esden/pretty-kicad-libs/README.md

This project has moved to [codeberg](https://codeberg.org/esden/pretty-kicad-libs).
