esden/pretty-kicad-libs/3d_models/M2_Standoff/M2_Standoff.FCStd

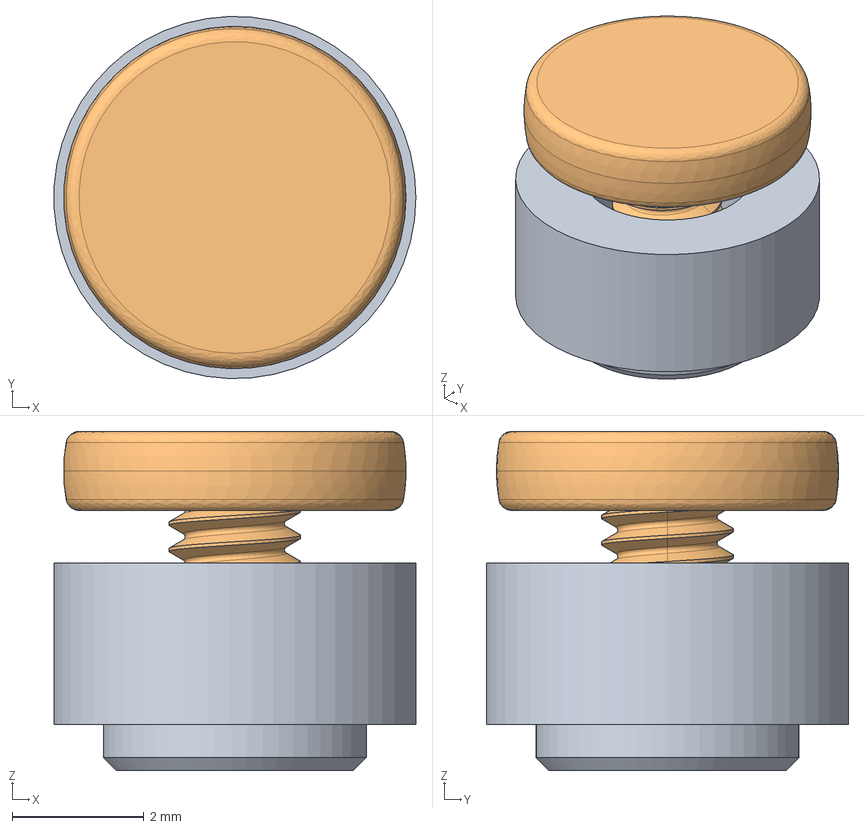
[picture p1: CAD file, 2021-06-23, last stored version]
3d_models/M2_Standoff/M2_Standoff.FCStd
5.49 x 5.50 x 5.15 mm
