esden/pretty-kicad-libs/3d_models/NGFF_Module/NGFF_Module.FCStd

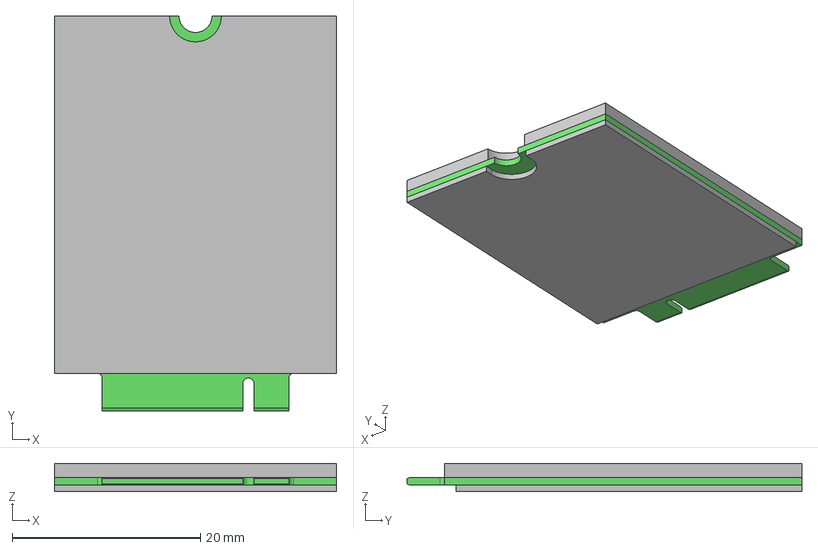
[picture p2: CAD file, 2021-06-23, last stored version]
3d_models/NGFF_Module/NGFF_Module.FCStd
30.0 x 42.0 x 3.00 mm
