esden/pretty-kicad-libs/3d_models/PogoPin_D0.68mm_L16.5mm/PogoPin_D0.68mm_L16.5mm.FCStd

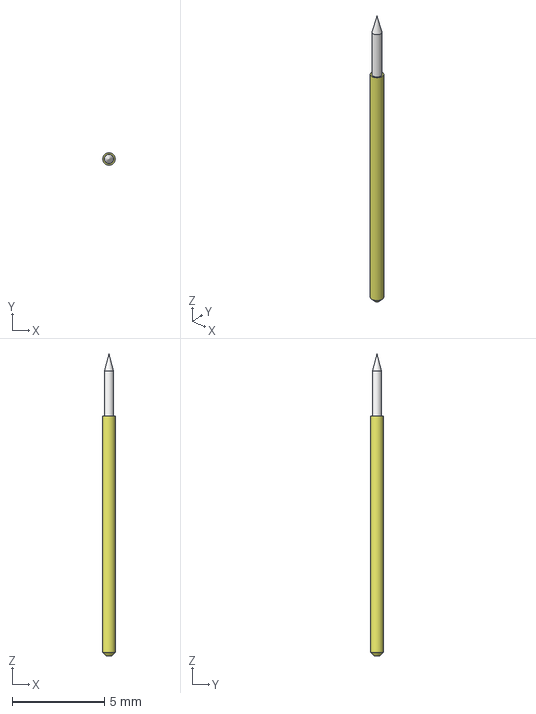
[picture p3: CAD file, 2021-06-23, last stored version]
3d_models/PogoPin_D0.68mm_L16.5mm/PogoPin_D0.68mm_L16.5mm.FCStd
0.679 x 0.68 x 16.4 mm
Sleeve001
Pin
