esden/pretty-kicad-libs/3d_models/M2_Screw/M2_Screw.FCStd

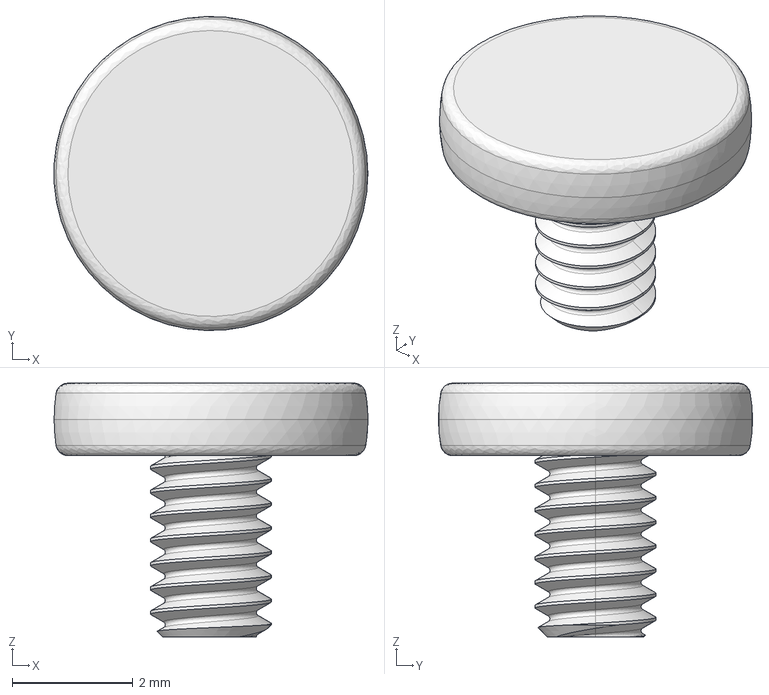
[picture p4: CAD file, 2021-06-23, last stored version]
3d_models/M2_Screw/M2_Screw.FCStd
5.20 x 5.20 x 4.20 mm
