esden/pretty-kicad-libs/3d_models/Molex_SL/705430041.stp

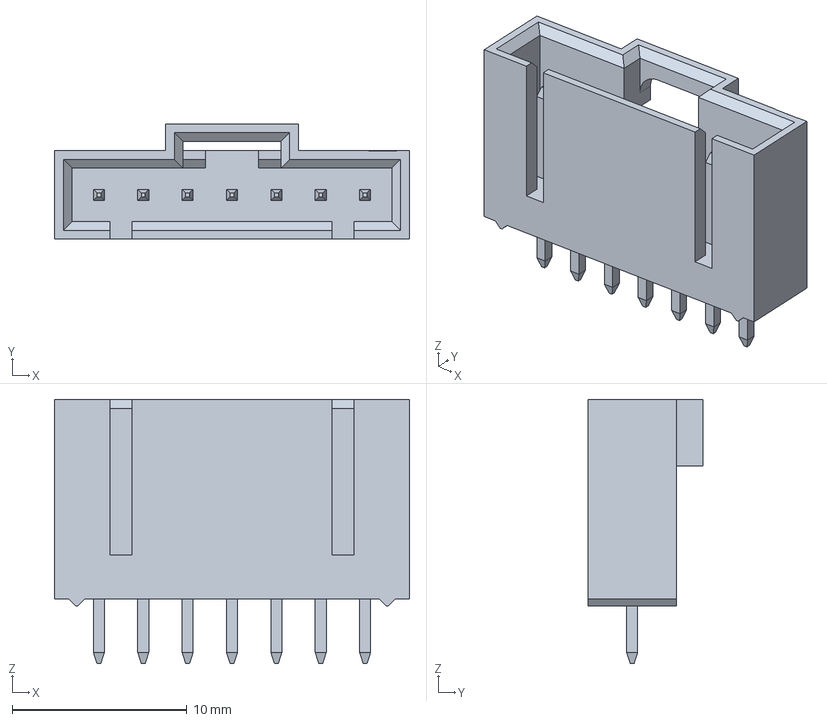
[picture p5: CAD file, 2024-10-26, last stored version]
3d_models/Molex_SL/705430041.stp
20.3 x 6.60 x 15.1 mm
