esden/pretty-kicad-libs/3d_models/Molex_SL/705430045.stp

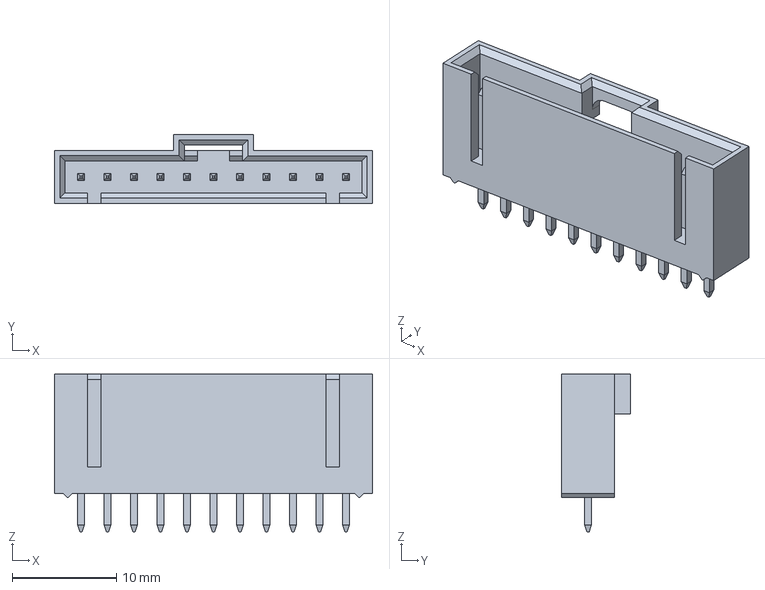
[picture p6: CAD file, 2024-10-26, last stored version]
3d_models/Molex_SL/705430045.stp
30.5 x 6.60 x 15.1 mm
