esden/pretty-kicad-libs/3d_models/Molex_SL/705430056.stp

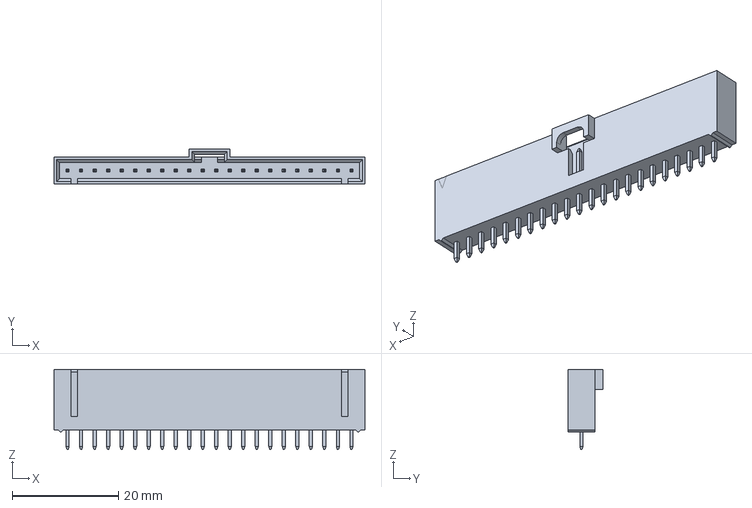
[picture p7: CAD file, 2024-10-26, last stored version]
3d_models/Molex_SL/705430056.stp
58.4 x 6.60 x 15.1 mm
