esden/pretty-kicad-libs/3d_models/Molex_SL/705430044.stp

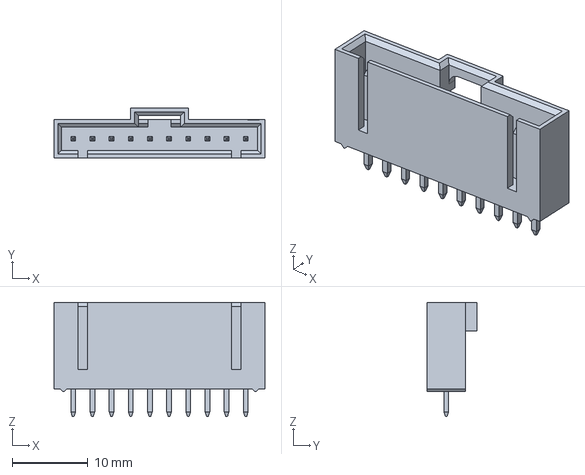
[picture p8: CAD file, 2024-10-26, last stored version]
3d_models/Molex_SL/705430044.stp
27.9 x 6.60 x 15.1 mm
