esden/pretty-kicad-libs/3d_models/Molex_SL/705430053.stp

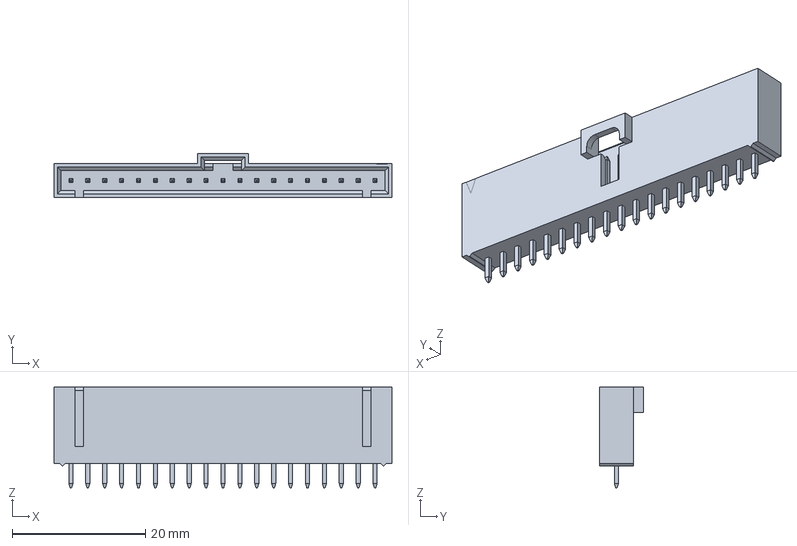
[picture p9: CAD file, 2024-10-26, last stored version]
3d_models/Molex_SL/705430053.stp
50.8 x 6.60 x 15.1 mm
