esden/pretty-kicad-libs/3d_models/Molex_SL/705430038.stp

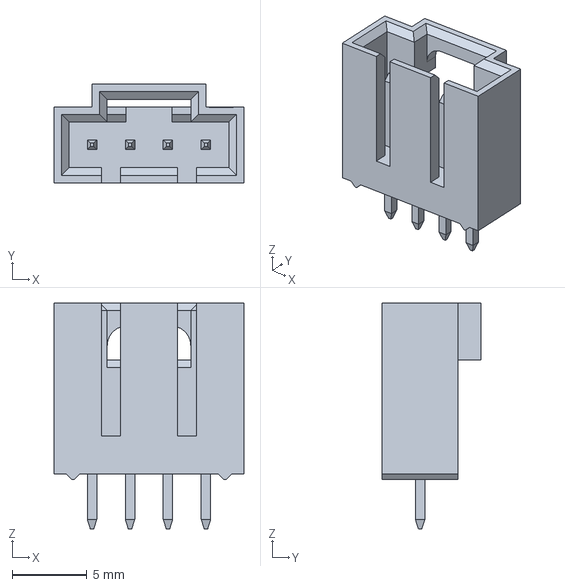
[picture p10: CAD file, 2024-10-26, last stored version]
3d_models/Molex_SL/705430038.stp
12.7 x 6.60 x 15.1 mm
