esden/pretty-kicad-libs/3d_models/Molex_SL/705430048.stp

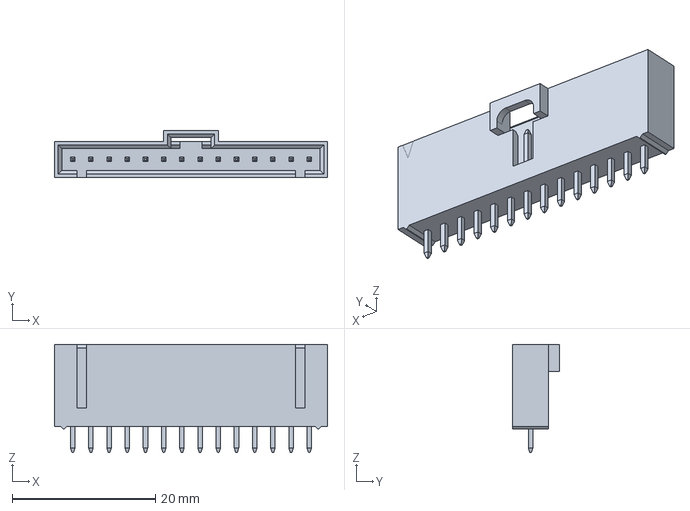
[picture p11: CAD file, 2024-10-26, last stored version]
3d_models/Molex_SL/705430048.stp
38.1 x 6.60 x 15.1 mm
