esden/pretty-kicad-libs/3d_models/Molex_SL/705430052.stp

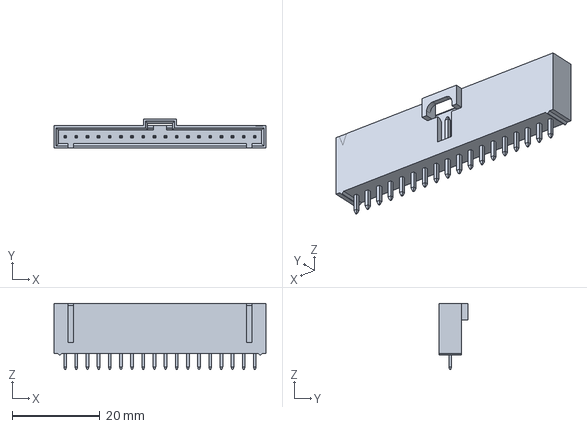
[picture p12: CAD file, 2024-10-26, last stored version]
3d_models/Molex_SL/705430052.stp
48.3 x 6.60 x 15.1 mm
