esden/pretty-kicad-libs/3d_models/Molex_SL/705430059.stp

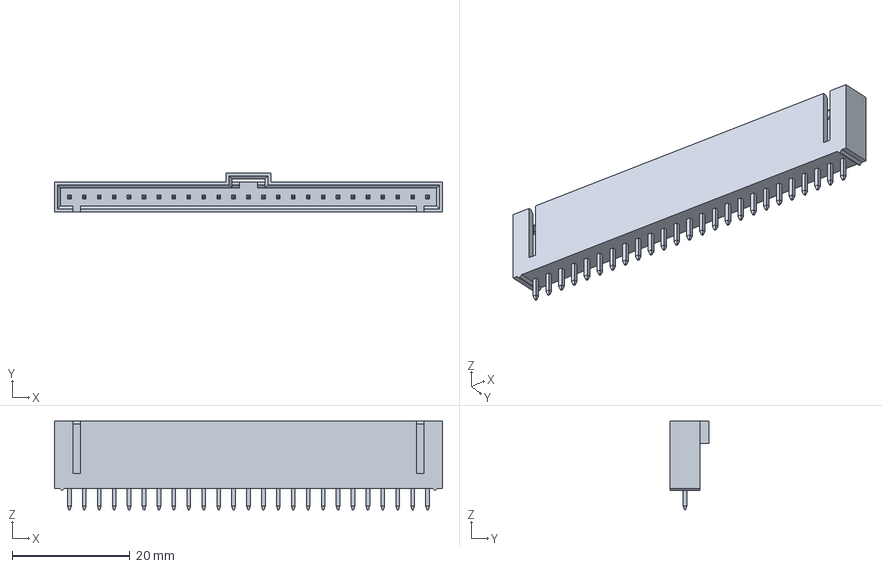
[picture p13: CAD file, 2024-10-26, last stored version]
3d_models/Molex_SL/705430059.stp
66.0 x 6.60 x 15.1 mm
