esden/pretty-kicad-libs/3d_models/Molex_SL/705430042.stp

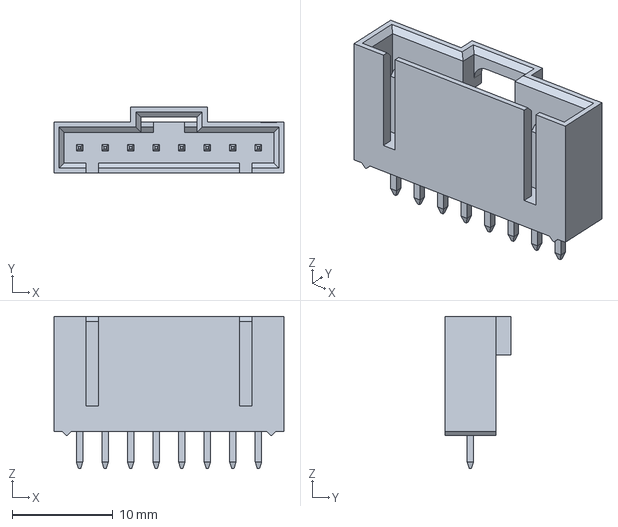
[picture p14: CAD file, 2024-10-26, last stored version]
3d_models/Molex_SL/705430042.stp
22.9 x 6.60 x 15.1 mm
