esden/pretty-kicad-libs/3d_models/Molex_SL/705430057.stp

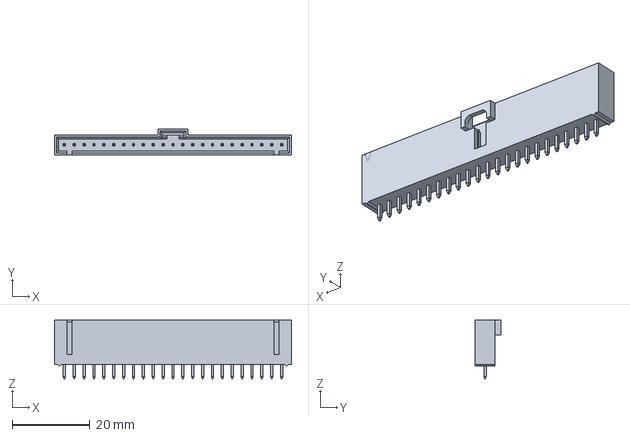
[picture p15: CAD file, 2024-10-26, last stored version]
3d_models/Molex_SL/705430057.stp
61.0 x 6.60 x 15.1 mm
