esden/pretty-kicad-libs/3d_models/Molex_SL/705430036.stp

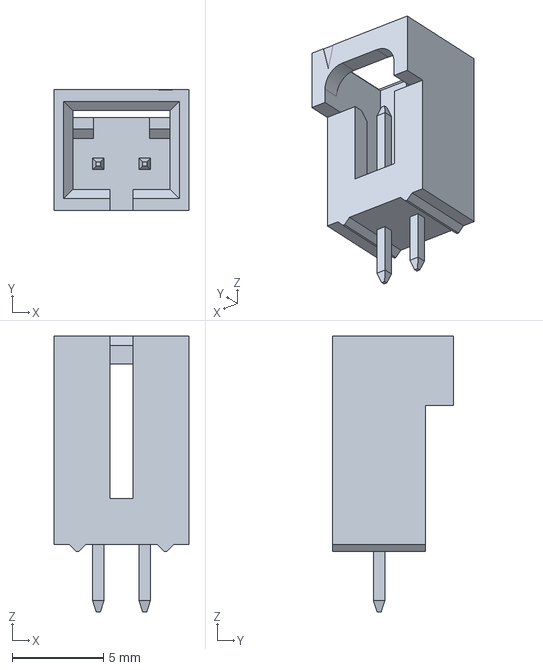
[picture p16: CAD file, 2024-10-26, last stored version]
3d_models/Molex_SL/705430036.stp
7.37 x 6.60 x 15.1 mm
