esden/pretty-kicad-libs/3d_models/Molex_SL/705430039.stp

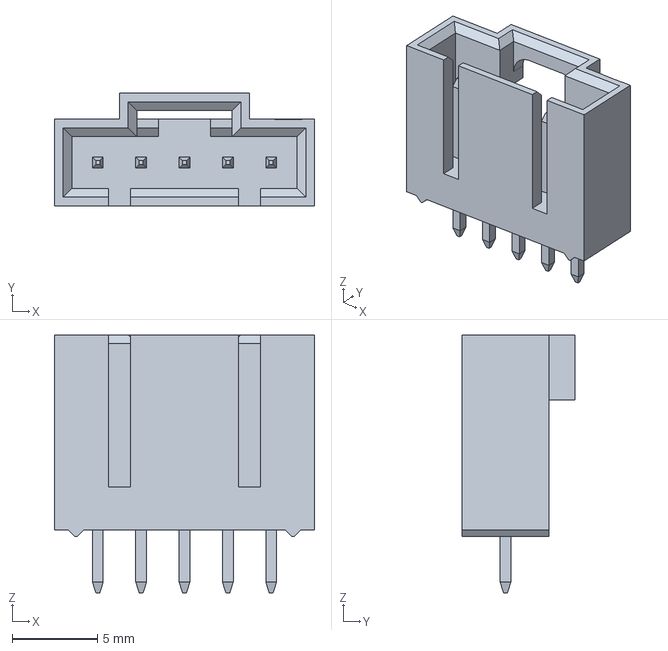
[picture p18: CAD file, 2024-10-26, last stored version]
3d_models/Molex_SL/705430039.stp
15.2 x 6.60 x 15.1 mm
