esden/pretty-kicad-libs/(list of files, cad)

Other CAD files:
3d_models/Molex_SL/705430037.stp
3d_models/Molex_SL/705430040.stp
3d_models/Molex_SL/705430043.stp
3d_models/Molex_SL/705430046.stp
3d_models/Molex_SL/705430047.stp
3d_models/Molex_SL/705430049.stp
3d_models/Molex_SL/705430051.stp
3d_models/Molex_SL/705430054.stp
3d_models/Molex_SL/705430055.stp
3d_models/Molex_SL/705430058.stp
