esden/pretty-kicad-libs/(commit log)

2015-04-02 Added thermal pad pin to NCP5911.
2015-04-02 Added R, C, L, TH to the device lib.
2015-04-02 Made the devices comply with the KLC.
2015-04-04 Renamed pad to 9. As the footprints use that instead.
2015-04-04 Some improvements to the MOSFET symbols.
2015-04-06 Initial commit of a few footprints.
2015-04-08 Added pad symbol and footprint.
2015-04-14 Added Res,Cap,Ind and Diode footprints in the pel style.
2015-04-14 Added 0201-2512 capacitor footprints.
2015-04-15 Added single and dual led symbols.
2015-04-15 Added 3 different dual LED footprints.
2015-04-16 Added 10pin JTAG connector symbol.
2015-04-16 Added FTSH board edge connector footprint.
2015-04-16 Improved the 3x3 smd pad footprint.
2015-04-16 Added a 1x1 mm SMD pad footprint.
2015-04-16 Added smaller 1x1 pad symbol.
    This should be consolidated. We should only have one schematic symbol
    for pads.
2015-04-17 Added NC7NZ34 buffer driver symbol.
    This is useful if you need to add 5V tolerance to non 5V tolerant pins.
    Also you can drive higher impedance lines with it.
2015-04-17 Added VFSOP-8 (US8) footprint.
2015-04-17 Added dual solder jumper symbol.
2015-04-27 Added 1b2 silkscreen logo.
2015-05-25 Added dual row 3pin header.
    This is in the right format for the right angle 3pin headers we use for
    servos.
2015-05-25 Removed names from the pin header pins.
2015-05-25 Added four resistor array symbol.
2015-05-25 Changed connector pin type to passive.
2015-05-25 Added Tact Switch symbol.
2015-05-26 Added diode symbols.
2015-05-26 Made the GND pin on the VREG a power input.
2015-05-26 Made the NC pins on MPU-9250 passive.
    NC is not really the right choice as we are allowed to route through
    those pins. If we set the pins to NC they are a hard indication to ERC
    that one must not connect anything to them. We need to make the decision
    if we leave the pins unconnected on the schematic level instead.
2015-05-28 Tact Switch case pin renamed to GND.
2015-05-29 Added a bunch more footprints that I need.
2015-05-29 Added 0603 diode footprint.
2015-05-29 Corrected symbol pin naming to match footprints.
2015-05-29 Added pkl prefix to all devices. eeschema seems to have trouble keeping track which library the symbol came from. >_<
2015-05-31 Diode footprints use electrode names to avoid issues in the future.
2015-05-31 Made pads and footprints smaller.
    We do not have luxury to use any space we want for pin headers.
2015-05-31 Added 3mm mounting hole footprint.
2015-05-31 Added QFN 24 3x3mm with larger pads.
    This makes soldering of the MPU-9250 more reliable.
2015-06-09 Added BeagleBoneBlack cape footprints.
    4 different types:
    - Classic through hole header
    - SMD header (i.e. Samtec TSM-123-01-T-DV)
    - SMD header with alignement pins (i.e. Samtec TSM-123-01-T-DV-A)
    - SMD header with locking pins (i.e. Samtec TSM-123-01-T-DV-LC)
2015-06-18 Added PCA9306 I2C level shifter symbol.
2015-06-19 Added pin numbers.
2015-06-26 Added LQFP100 footprint.
2015-07-13 Corrected JST connector pad layers.
2015-07-13 Adjusted layer settings for pin header footprints.
2015-09-06 Added SOT23-6 footprint.
2015-09-07 Adjusted jumper symbol to match better the resistor symbol as they are very close cousins. :)
2015-09-08 Added SOT353 footprint.
2015-09-10 Added coaxial connector symbol.
2015-09-12 Added RJ45 with magnetics symbol.
2015-09-13 Added SD Card connector symbol.
2015-09-16 Added a jtag connector symbol with 10 aux pins.
2015-09-17 Added samtec FTSH-110 DV footprint.
2015-09-17 Added U.FL coax connector footprint.
2015-09-17 Adjusted pin functions to make ERC happy.
2015-09-19 Added "inverted" extended JTAG connector.
2015-09-19 Corrected the FTSH 110 footprint.
2015-09-19 Added via footprint for easier via stitching.
    The notation is 03 for .3mm drill and 05 for .5mm copper resulting in a
    .1mm restring width.
2015-09-20 Added QFN32 footprint with large pads.
2015-09-23 Added 6 pin header symbol.
2015-09-23 Decreased solder paste amount on thermal pad.
2015-09-25 Added 0603 inductor footprint.
2015-09-30 Added MAX-7 GPS module footprint.
2015-09-30 Added two more antenna symbols.
2015-09-30 Added polarized capacitor symbols.
2015-10-04 Added two more MOSFET symbols.
2015-10-06 Added Taoglas GPS & GLONASS 25mm patch antenna footprint.
2015-10-06 Added coin supercap footprint.
2015-10-06 Added Taoglas GPS/GLONASS 35mm patch antenna footprint.
2015-10-08 Added WE 20mm x 20mm RF shield footprint.
2015-10-09 Some pin function fixes.
2015-10-14 Removed solder stop from the bosses, to gain NPTH.
    If you have solder stop on the bosses they will be considered plated
    through. Removing the solder stop will result in a NPTH. At least this
    is how OSHpark is doing this...
2015-10-16 Added HM-TRP footprints.
2015-10-19 Added Samtec TSM and SMH footprints.
2015-10-20 Added USB A SMD and USB A SMD simplified footprints.
    The simplified footprint uses a via for the shield instead of slots.
2015-10-20 Added QFN 20 .5pitch footprint.
2015-10-26 Added LXDC55F DCDC regulator symbol.
2015-10-27 Added ACS758x PFF footprint.
2015-10-27 Added LXDC55F footprint.
2015-10-27 Set the footprint for LXDC55F.
2015-10-27 Removed copper polygons.
    KiCad does not recognize that copper polygons overlapping pads should be
    the same net as the pads. This means we can not use them for arbitrary
    shaped pads. :(
2015-10-27 Improved the ACS758 footprint.
2015-11-04 Corrected the PCB edge...
2016-01-22 Added 7A series XTAL footprint.
2016-01-22 Added pad pin to the TXS0108 symbol.
2016-01-22 Added SOT-666 footprint.
2016-01-26 Added dual P-MOSFET symbol.
2016-01-31 Added tact switch symbol without grounded shield.
2016-02-04 Added 20pin JTAG connector symbol.
2016-02-04 Added BlackSphere logo and Samtec FTSH-105 footprint.
2016-02-06 Added 7x7mm .5mm pitch BGA packages.
2016-02-08 Added BLE121LR footprint.
2016-02-14 Added center pad pin to the C8051F330 symbol.
2016-02-16 Corrected the SOT666 footprint to be not so huge...
2016-02-19 Added flash and grounded antenna symbols.
2016-02-19 Added DFN-8 8x6mm and smd gps patch antenna footprints.
2016-04-08 Trying to improve the SOT-666 footprint.
2016-04-08 Converted the SOT-666 footprint to oval pads.
    Also removed the solder paste pullback, as we were lacking solder paste.
2016-04-08 Converted the generic QFN-48 to match STM32F1 with oval pads.
2016-04-09 Another iteration on the QFN-48 footprint.
2016-04-09 Improved footprint to be closer to the recommended one.
    We had very large fillets on the outside of the package, so we were able
    to shrink the footprint a bit, which is closer to the recommended
    footprint anyways.
2016-04-09 Added courtyard to the footprint.
2016-04-30 Added Tag Connect symbols and footprints.
    Based on the files released by Tag Connect. Updated to the new formats
    and design rules.
2016-05-08 Added dual N-MOSFET symbol.
2016-05-21 Removed unnecessary layers from holes in tag connect footprints.
2016-05-21 Added 1mm x 1.5mm pad.
2016-05-21 Added QFN 36 6x6mm 0.5mm pitch footprint.
2016-07-07 Added single pin, pin header.
2016-07-07 Added ABS07 crystal footprint.
2016-07-07 Added a 1x2.65mm pad.
2016-07-07 Added a 1x1mm round pad for the use with pogopins.
    This pad additionally has a courtyard indicating how far the pads have
    to be away from each other so that it is possible to create the
    corresponding pogo pin adapter and be able to route it without special
    tollerances.
2016-07-14 Added a ti 20pin 50mil JTAG castelleted hole footprint.
2016-07-22 Improved the tollerance of the pin header round footprints.
2016-08-21 Removed the default solderstop opening setting.
2016-08-25 Added 0603 Resistor footprint.
2016-08-25 Added 0603 solder jumper.
2016-08-25 Added via footprint with .25mm drill and .1mm restring.
2016-08-25 Added 0.1" pitch 2x10 SMD pin header footprint.
2016-08-25 Added small 0.1mm grid pixel heart.
2016-09-12 Added maxim SPI IO port expander symbols.
2016-10-25 Added DHVQFN-16 footprint.
2016-10-25 Added QFN 32 footprint.
2016-10-25 Added PRQC resonator footprint.
2016-10-25 Added 6.5mm logo.
2016-10-25 Added convex 4x0402 resistor array footprint.
2016-10-26 Added SOT-1089 and SOT-996-2 footprints.
2016-10-26 Added SOT833-1 footprint.
2016-11-03 Added 0.5" pitch header type pad.
2016-11-06 Added capacitive touchscreen symbol.
2016-11-14 Added 50pin and 60pin 0.5mm pitch FFC connector footprints.
2017-06-18 Added a generic LCD 50pin connector with logically sorted pins and cap labels.
    This symbol is based on the Adafruit symbol used in the TFT cap touch
    breakout boards. The resistive touch pins can in some cases be reused as
    i2c capacitive touch sensor outputs.
2017-06-18 All tact switches now have 10% paste pullback.
2017-06-18 Added th 7.8 snapin tact switch footprint.
    This footprint is based on the Alps SKEY footprint.
2017-06-18 Added ALPS micro SD card footprint.
2017-06-22 Added SPDT switch symbol.
2017-06-23 Added QFN-16-1EP_3x3 pitch 0.5mm footprint with thermal pad vias.
2017-06-23 Added power supply pins to the 74HC165 symbol...
2017-06-24 Added TSSOP 16 4.4x5mm 0.65mm pitch.
2017-06-24 Added MCP4661 dual digital i2c potentiometer symbol.
2017-06-25 Added C&K PCM12SMTR SPDT slide switch footprint.
2017-06-25 Added stereo 3.5mm jack symbol with one switch.
2017-06-25 Added SJ2-35853B-SMT footprint.
    This is a narrow footprint, 3 conductor 1 switch, smd stereo 3.5mm audio
    jack with guide pin and board edge recess.
2017-06-25 Added QFN-16-1EP 4x4 Pitch 0.65mm footprint.
2017-06-25 Added MILL-MAX 0906-1 pogopin pad footprint.
2017-06-25 Added silkscreen 0.25mm grid pixel heart logo.
2017-06-26 Added a mechanical footprint for a 2.8" tft display with cap touch.
    This footprint does not contain any electrical parts only mechanical
    information and drawings including the registration holes for the
    display, and where recommended cutouts should go to feed the ribbon
    cables to the reverse side of the PCB. The drawing is based on the
    buydisplay.com ER-TFT028-4 display with ER-TPC028-4.1 capacitive touch
    sensor. I have also merged the outlines found on Adafruit breakouts to
    hopefully allow the same footprint to be used with her displays. (sadly
    Adafruit does not share information where she is getting her displays or
    selling her displays without breakout boards, but if you already have a
    dis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
2017-06-28 Added silkscreen art to the micro SDCard footprint.
2017-06-29 Added 18650 clip battery holder.
2017-06-29 Added silkscreen outline to the audio jack footprint.
2017-06-30 Removed built in solder stop opening setting.
2017-06-30 Fixed mill max pad to make KiCad connect the two sides together.
2017-06-30 Turns out polygons like that don't export to gerber correctly. Converted back to mask layer.
2017-09-14 Added QFN 56 8x8mm 0.5mm pitch.
2017-10-08 Added DFN 8 1ep 1.35mm x 1.7mm 0.4mm pitch footprint.
2017-10-08 Added Samtec TFC 106 SMD connector footprint.
2017-10-08 Added FX2 symbol pad pin.
2017-10-08 Added IP425x-4-TTL symbol. EMI/ESD filter with 4 channels.
2017-10-27 Corrected the Cortex+ETM debug connector symbol.
2017-12-08 Added placeholder BlackSphere logo symbol.
    Nightly build KiCad needs to have all footprints associated with symbols
    of the schematic so we need at least a placeholder symbol for the
    BlackSphere logo footprint.
2017-12-20 Added 3mm 1b2 logo.
2017-12-20 Added a few STM32 BGA/WLCSP packages.
2017-12-22 Added Super Capacitor in 1210 package footprint.
2017-12-22 Added SiT8021 oscillator footprint.
2017-12-22 Added ADP7118 symbols and LFCSP footprint.
2017-12-22 Added LED_ARGB symbol.
2017-12-22 Added common anode tricolor 0404 footprint.
2017-12-24 Added MicroPak footprint for ONSemi NC7SZ14.
2017-12-24 Added a 1mm pitch pad array.
2018-01-07 Added QFN-64-4.45mm1EP_9x9mm_Pitch0.5mm footprint.
    This is used by the FTDI FT2232HQ part. (it has an odd ground pad :D )
2018-01-07 Added pad VIA to the QFN-64-4.45mm1EP_9x9mm_Pitch0.5m footprint.
2018-01-08 Added SOIC-8 5.3mm wide package.
2018-01-08 Added PTS645 footprint.
2018-01-14 Added KMR2 footprint and 3d model.
2018-02-16 Cleaned up and adjusted to the PKL standard the LFCSP-6 footprint.
2018-02-16 Corrected name to 1mm pitch and added smaller pinouts of the SMD Pad Array.
2018-02-16 Added new and improved QFN 24 0.4mm pitch footprint.
2018-02-16 Added mousebite ready drill footprint.
2018-02-16 Added ASCO Abracon oscillator footprint.
2018-02-18 Improved footprint based on the IPC wizard.
2018-02-18 Added courtyard to the LFCSP footprint.
2018-02-18 Added courtyard to the MS5611 footprint.
2018-03-06 Initial commit of VNH5019A-E integrated H-Bridge footprint
2018-03-10 Added ADS7953SRHBT TI 16ch 12bit ADC symbol.
2018-03-12 Added QFN-48 8x8mm footprint.
2018-03-14 Added FTSH 50mil 20pin board edge connector footprint.
    This is meant for 0.8mm boards that can be slipped between the legs of a
    0.05" pitch pin header and used in RA orientation.
2018-03-21 Removed paste from SMD pad arrays.
    These pads usually do not get smd parts soldered on.
2018-03-21 Removed paste layer from the edge connector footprint.
2018-03-25 Updated the QFN 20 4x4 .5 pich footprint.
    The new footprint also includes thermal vias.
2018-03-25 Added Swichcraft 35RAPC2AH3 3.5mm audio jack footprint.
    This footprint is based on @kbob design with minor changes:
    * Converted pads to oval pads using datasheet dimensions.
    * Added FFab and Courtyard drawings.
    * Made the silkscreen drawing bit thinner.
    * Adjusted file naming to match the KiCad standard bit better.
    * Renumbered pads to match the default KiCad symbol signal numbering.
2018-04-01 Added Bourns 3352T potentiometer footprint.
2018-04-01 Added SPV1840LR5H footprint.
2018-04-01 Assigned footprint to the SPV1840LR5H microphone symbol.
2018-04-09 Fixed pinout.
    Some of the combined GND pins were not correctly mapped.
2018-04-10 Added DFN-8-3x2 0.5mm pitch footprint.
2018-04-19 Changed to an improved version of the SOT-666 footprint.
2018-04-19 Added right angle 0603 led footprint.
2018-04-20 Added ML414 battery retainer.
2018-05-04 Added BGA-24 footprint used by Cypress HyperRAM.
2018-05-07 Improved convex quad 0402 resistor array footprint.
2018-05-07 PMOD dual row header.
    The numbering on the pads of those connectors is reverse and row by row.
    There is no correct footprint in the standard kicad library for that.
2018-09-02 Updated all dipol footprints.
    Now that V5 is out we can use roundrect pads. Also updated 3d model
    links to use the new 3d library naming.
2018-09-02 Converted more footprints to use roundrect pads.
2018-09-06 Corrected the solder stop opening to be symmetric.
2018-09-06 Added symbol and footprints for normally connected solder jumpers.
2018-09-06 Swap RESET and REF pins. This makes schematics easier to read.
2018-09-21 Added TQFP-64-1EP footprint.
2018-09-22 Added HDMI 10029449-111RLF connector footprint.
2018-09-22 Add PAD pin to TFP410 symbol.
2018-09-27 Added SPST SKPM button footprint.
2018-10-11 Added footprint for the LTD-6910HR 7Segment led display.
2018-10-14 Added a two state jumper symbol with one leg normally closed. And footprints.
2018-10-14 Added new tact switch footprint.
2018-10-14 Made the tact switch pads roundrect.
2018-11-17 Added PTS810 tact switch 3d model.
2018-11-18 Added Cree PLCC6 3.4mm x 3.4mm RGB LED footprint.
2018-11-19 Removed solder paste from all jumpers.
2019-04-11 Added SN450561N 7 segment LED display symbol.
2019-04-11 Added SN450561N 7 Segment LED display footprint.
2019-04-11 Added PMOD header and socket footprints.
2019-05-12 Removed solder mask width margin setting.
    I have no idea how that snuck in there. But the library footprints
    should not come with that preset. It is very much board house capability
    dependent and has to be set on project by project basis.
2019-05-13 Added LED BGR symbol.
2019-05-13 Added Diode SOD-503 footprint.
2019-05-13 Corrected SOD-523 diode footprint pads.
    The pads all have to be roundrect. The Diodes are referenced as C and A
    not by number to prevent errors.
2019-05-13 Corrected pads to roundrect for the Cree PLCC6 footprint.
2019-05-13 Removed fab layer part drawing for the resistor arrays.
    These fab layer drawings are not very useful and are in the way when
    creating placement plans and wanting to place part ID inside the
    courtyard boxes.
2019-05-15 Updating the QFN style.
    * roundrect pads
    * roundrect thermal pad
    * corrected solder aperture size (60%-65% coverage now it was much lower
    than that in a lot of cases)
    * using single copper pad for thermal and multiple separate solder paste
    apertures on top. This gives a finer control over coverage and size.
    * removed fab layer detailed part drawing where applicable (it is not
    helpful and is in the way of placement plans)
2019-05-16 Initial commit of a Micro USB connector with solder tabs.
2019-06-02 Updated footprint to match better the IP425 part.
2019-06-05 Roundrect pads for tact switches.
2019-06-05 Some more roundrectified footprints.
2019-07-01 Added 2mm long tab.
2019-07-02 Made the TFP410 compatibility pad pin label bit clearer.
2019-07-21 Some footprint type adjustments.
    Made a bunch of footprints SMD/Virtual instead of the TH default.
2020-03-28 Added Tri color (RGB) 1010 footprint.
2020-04-02 Added SCTF_S2DXX oscillator footprint.
2020-04-16 Added Molex SL 70551 through hole 5 pin connector footprint.
2020-04-16 Added Switchcraft 3.5mm connector and 74AUP2G3404 buffer/inverter chip.
2020-04-16 Added SNES console side connector footprint and 3d model.
    The 3D model is from: https://www.raphnet-tech.com/products/snes_controller_connector/index.php
    The footprint as a heavily modified and updated version of the footprint
    found in: https://github.com/imciner2/KiCad-Libraries
    The new footprint should have the correct keepouts to match vertical
    connectors found in usual asian markets.
2020-05-22 Add VBAT and VIN power symbols
2020-05-27 Add LED_TRI_2020, fix other LED_TRI descriptions
2020-05-29 Fix LED_RBAG pins
2020-06-03 Fix fabrication attributes for virtual footprints
2020-06-03 Change LED footprints fabrication attribute to SMD
2020-06-04 Add castellated pin header
2020-06-04 Fix footprint attributes (PTH -> SMD/Virtual)
2020-06-06 Add Creative Commons silkscreen symbols
2020-06-09 Add 2mm 1b2 & null logos
2020-07-29 Added a USB-AC combo connector symbol and footprint.
2020-08-06 Added NES connector footprint.
2020-08-12 Add colored button model from @gregdavill
2020-08-17 Add iCEBreaker Bitsy SMD and THT footprints
2020-08-17 Add iCEBreaker Bitsy footprint filter
2020-08-17 Adjust PMOD silkscreen
2020-08-17 Add courtyard to iCEBreaker Bitsy footprints
2020-08-17 Change iCEBitsy footprint types to SMD
2020-10-13 SNES FP: Increas hole size to match thicc-pin sockets.
2020-10-17 Removed solder stop expansion settings.
2020-10-17 Added paste apertures for USB-C connector shield pin in paste.
2020-10-20 Fix courtyard & silkscreen
2020-10-20 Standardize courtyard/silkscreen & fix incorrect pad 6
2020-10-20 Added icebreaker-bitsy reverse mount footprint.
2020-10-28 iCEBitsy: update to v1.1b - add iCEBitsy 3D model - update board outline - add programming pins to symbol & footprints - add board cutout for reverse mount footprint
2020-10-30 iCEBitsy: add SPI pins & improve footprints
2020-11-10 Added converted KiCad V6 format symbol libraries.
2020-11-18 Added C-AW10-AK5V50 USB-C free hanging connector PCB edge footprint.
2021-01-26 Add NGFF footprint
2021-01-26 Add Lattice caBGA-381 & csfBGA-285 footprints
2021-01-26 Add USB332x WLCSP footprint
2021-01-26 Add Etron RPC DRAM footprint
2021-01-26 Add missing footprint descriptions
2021-01-26 Add footprint for MKDV64GCL SD NAND flash
2021-01-26 Add PCIe M.2 module standoff footprint
2021-01-26 Add microSD card & socket
2021-01-26 Add Molex microSD socket 3D model
2021-01-27 Added 2x22 PinHeader footprints.
2021-01-27 Added 0805 inductor footprint.
2021-01-31 Corrected the pass through CLP socket footprint and added 3d model.
2021-02-06 Add Hirose BM28 connector footprints
2021-02-06 Add R_0201 footprint
2021-02-06 Add +1V2A power symbol
2021-02-09 Add TE 2328702 FPC connectors
2021-02-09 Add Hirose BM28 mezzanine connectors
2021-02-09 Clean up Lattice BGA footprint variants
2021-02-09 Improve WLCSP footprint descriptions
2021-02-09 Add F.Fab to all pkl_dipol footprints
2021-02-18 Tweak M.2 connector symbol/footprint
2021-02-18 Update microSD connectors
2021-02-18 Update ECP5 symbol, delete redundant footprints
2021-02-18 Add XSON-8 footprints (Nexperia 74-series)
2021-02-20 Fix footprint values
2021-02-20 Add ON Semiconductor X2SON LDO footprint
2021-03-10 Fix MountingHole filled zone connections
2021-03-10 Add L_0201 footprint
2021-03-10 Update microSD_HS_Molex_1051620001 footprint
2021-03-25 Add Hirose BM28 connectors
    - added all 3D models from 6pin to 40pin
    - added footprints for 16, 20, 24, and 30pin
    - TODO: remaining footprints
    - added all symbols from 6pin to 40pin
    - TODO: add all integer symbols that don't have matching footprints
2021-03-25 Update NGFF A+E symbol/footprint
2021-03-25 Add 0806 inductor footprint
2021-03-25 Add TestPoint_Pad_D0.5mm footprint
2021-03-25 Add M.2 screw 3D model to mounting hole footprint
2021-03-25 Update USON-8-1EP_3x2mm_P0.5mm_EP0.2x1.6mm footprint
2021-03-25 Add TI TPS6280x WLCSP buck switcher symbol & footprints
2021-03-25 Add LGA-8_8x6.2mm_P1.27mm footprint
2021-04-13 Update M.2 symbol pin types
2021-04-13 Add DFN-6_1.0x1.0mm_P0.35mm footprint
2021-04-24 Add D_0402 footprint silk variants
2021-04-29 Add M.2 standoff footprint with vias
2021-04-30 Added LGA8 8x6.2mm package 3d model.
2021-04-30 Add 1.0x1.0mm RGB LED footprints
2021-04-30 Tweak M.2 standoff footprints
2021-05-05 Add GigaDevice GD25D80C symbol & 1.5x1.5mm USON-8 footprint
2021-05-08 Update 1b2 logos, add 6mm variant
2021-05-08 Change pin 1 silkscreen style
2021-05-08 Add Diodes X1/X2-DFN1010 footprints
2021-05-08 Adjust dipol silkscreens, general cleanup
2021-05-08 Adjust 0805 & 1206 pad sizes, update silkscreens
2021-05-12 Change order of M.2 UART pins
2021-05-12 Change MKDV64GCL ground pin name from VSS to GND
2021-06-05 Increased pin pad gap.
    Some board houses need 0.22mm gap to allow for soldermask between pins.
2021-06-06 Added ER-OLED0.91 footprint.
2021-06-11 Corrected the ER-OLED0.91 footprint.
2021-06-11 Improved the 0.5mm drill.
2021-06-11 Added 1.0mm mechanical drill.
2021-06-11 Added SOT-23 footprint.
2021-06-11 Corrected the SOT23 footprint.
2021-06-12 Corrected ER-OLED footprint and added 3D model.
2021-06-12 Added slide XKB SPDT slide switch footprint.
2021-06-14 Added courtyard and silkscreen.
2021-06-18 Add NGFF socket symbols and footprints
2021-06-23 Add Pogo Pins
    [PogoPin_D0.68mm_L16.5mm.FCStd, PogoPin_D0.68mm_L16.5mm.scad]
2021-06-23 Add crosshair footprints
2021-06-23 Add M.2 standoff footprint/3D model
    [M2_Screw.FCStd, M2_Standoff.FCStd]
2021-06-23 Add NGFF module footprints & 3D models
    [NGFF_Module.FCStd]
2021-06-25 Add TestPoint_Pad_D0.75mm
2021-06-25 Clean up logo footprints
2021-07-01 Corrected the ER-OLED footprint.
2021-07-04 Increased hole pad gap for easier assembly.
2021-07-14 Added LCFE201204 symbol and footprint.
2021-07-16 Added SNES connector symbol.
2021-08-11 Added HDMI connector 3D model.
2021-09-13 Added TPS62621 symbol and footprint.
2021-11-29 Minor update of SMD jumper footprints.
2021-11-29 Added 0602 (doublethrow 0402) NCNO jumper footprints.
2022-01-30 Removed legacy symbol libraries.
    Updated kicad project and indexes.
2022-01-30 Updated kicad symbol libraries to stable.
    Those were still saved with nightly.
2022-02-10 Converted ties to polygons instead of traces.
    This improves the DRC tolerance until we get native net tie support in
    KiCad.
2022-02-10 Added 3DModel to the button footprint.
2022-02-10 Added PKL_REL_DIR to the local 3D model paths.
    This makes it more portable between projects without having to make
    manual adjustments in the footprints for each project.
2022-02-10 Added 3D model to LED_TRI_2020
2022-03-28 Improved the STM32F103 symbol.
    Added multiple pin names and integrated the Five volt Tolerant markers.
2022-03-28 Added more JTAG/SWD pin header symbol variants.
2022-03-30 Increased pad gap to 0.22mm and more elaborate outline.
2023-09-20 Added AA battery holder.
2023-09-20 Added footprint for the MAX38640.
2023-09-20 Added AA battery holder footprint.
2023-09-20 Added Wuerth REDFIT spring loaded connector footprints.
2023-09-20 Added an FTSH-105-DV and Tag-Connect combo footprint.
    This allows the use of a regular ARM-Cortex JTAG connector for regular
    development as well as forgoing populating the connector and using
    Tag-Connect if needed in production.
2023-09-25 Improved silkscreen.
2023-09-25 Added battery strap lock locations.
2023-09-26 Added Amphenol MDT420E01001 M.2 connector 3D model.
2023-09-27 Added Wuerth 977402515r standoff 3D model.
2023-09-27 Added TI DMB0006A package used in the humidity sensors.
2023-09-27 Added 0.5mm wide connected normally closed jumper.
    Useful for power ties.
2023-12-19 Added TI High Side load Switch and Schottky diode symbols.
2024-05-22 Added Broadcom AFBR-S4N33C013 SIPM sensor.
    Silicon Photo Multiplier
2024-05-29 Added CUD7GF1B LED footprint.
2024-05-30 Updated to new KiCad.
2024-05-30 Added 4 pin Samtec TSM connectors.
2024-05-30 Added CUD7GF1B LED model.
2024-06-13 Added a quad jumper symbol and footprint.
2024-06-13 Added JST B2B-PH-SM4-TB connector 3d model.
2024-06-13 FTSH-104 Tag-Connect combo footprint, corrected pad numbering.
2024-06-13 Improved outline dimensions on dual NCNO jumper footprint.
2024-06-13 Added 1008 Inductor footprint.
2024-06-13 Added 1210 inductor footprint.
2024-06-13 Added DFN14 footprint.
2024-06-17 Improved paste openings for soldering reliability.
    This brings us closer to not having to rely on the stencil vendor to
    make stencil aperture adjustments for us which is quite error prone.
2024-07-27 Added X2 DFN 1210&1410 footprints.
2024-10-12 Corrected 4x resistor pack orientation.
2024-10-26 Added unified debug with trace connector symbols.
2024-10-26 Added Molex_SL-70543 3d models.
    [705430036.stp, 705430037.stp, 705430038.stp, 705430039.stp, 705430040.stp, 705430041.stp, 705430042.stp, 705430043.stp]
2024-10-31 Added AP1016AEN symbol and footprint.
2024-10-31 Added Samtec LSEM razorbeam connectors.
2024-10-31 Added Recom RSOC symbol and footprint. Also R-5 3d model.
2024-11-02 Added horizontal PMOD socket footprint.
2024-11-02 Adjusted parameters for PAD footprints.
2024-11-02 Updated PMOD Pin Socket footprint.
2024-11-02 Updated Drill footprint.
2024-11-16 Added EC-EZO module symbol and footprints and associated 3d models.
2024-11-16 Added blues wireless module assemblies.
    Two versions are available:
    * Flush to pcb
    * Elevated allowing for ~2mm space for circuitry below the Blues module.
2024-11-16 Added Amphenol 132134 TH vertical SMA connector.
2024-11-18 Updated and added 3D models for the FTSH connectors.
    Now the FTSH connectors also show the plug to help avoid collisions in
    production.
2024-11-26 Corrected hidden pin mode.
    Hidden pins that are not passive push net names, which causes a lot of
    trouble.
2024-11-26 Updated power symbols to newer way of doing it.
2024-11-26 Added 0.1mm wide nettie.
2024-11-28 Added zener diode symbol.
2024-12-22 Removed unnecessary notecard courtyard for the elevated footprint. Added courtyard to the boss.
2024-12-22 Added split EC-EZO symbol and footprint.
    This allows us to create proper BOM entries for this thing.
2025-01-19 Added PCIE 1X physical pinout connector symbol.
2025-01-19 Added PCIE1X SMD footprint and 3D model.
2025-05-18 Updated 1206 footprint dimensions.
2025-05-18 Added 2010 resistor footprint.
2025-05-18 Added WSON 10 2.2x2.0mm footprint.
2025-06-03 pkl_misc: KiCAD v8 -> v9 making a mess.
2025-06-03 Added Broadcom 4x4 SiPM footprint.
    I did a dumb and lost the 2x2 and 6x6 footprints. :-(
2025-06-06 Added X2-DFN1410 footprint.
2025-06-06 Added DFN-6-1EP-1.8x1.5_P0.5 footprint.
2025-06-06 Added SMD half pitch recepticle footprint 62301021021.
2025-06-11 Add some power symbols to make ERC happy.
    Also a KiCAD V8 -> V9 upgrade.
2025-06-11 Add TPS55340 regulator symbol.
    I think I abandoned use of this regulator before I even finished the schematic.
2025-06-11 Tiny TPS61391 symbol pin position tweak.
2025-06-11 Added TPS92391 LED driver symbol.
2025-09-13 Footprint for 3.5 x 3.5 power LED
2025-09-14 Removed duplicate nc pin.
2025-10-11 Würth soldered threaded standoffs. Cleaned up and added 2mm dia version.
2025-11-24 UV LED 3D model path fix, Wurth inductor 3D model added.
2026-03-19 pkl_misc: Added a 1.02mm dia pogo pin footprint for the P75 pogo
2026-07-18 We have moved to codeberg.
    [705430036.stp, 705430037.stp, 705430038.stp, 705430039.stp, 705430040.stp, 705430041.stp, 705430042.stp, 705430043.stp]
